kliment/catws/boardshape.dxf

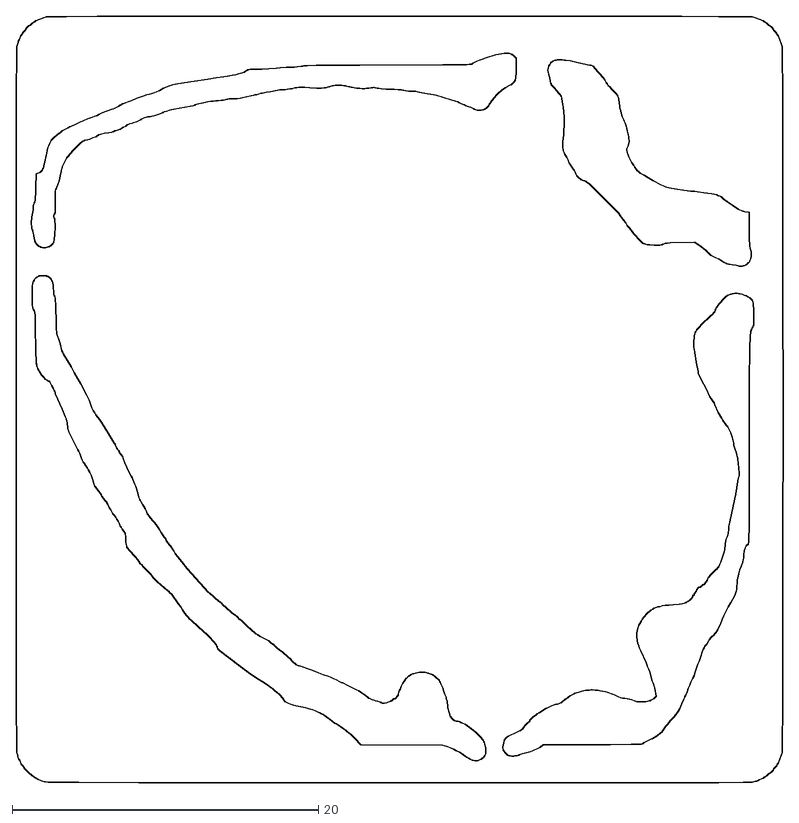
[picture p1: CAD file, 2019-01-30]
boardshape.dxf
50.1 x 50.1
