kliment/catws/boardshape.scad

translate([-51.5,-93.75])import("outline-npl.dxf");
