kliment/catws/catws-r2.kicad_pcb

## KiCad design catws-r2.kicad_pcb (2019-12-14)

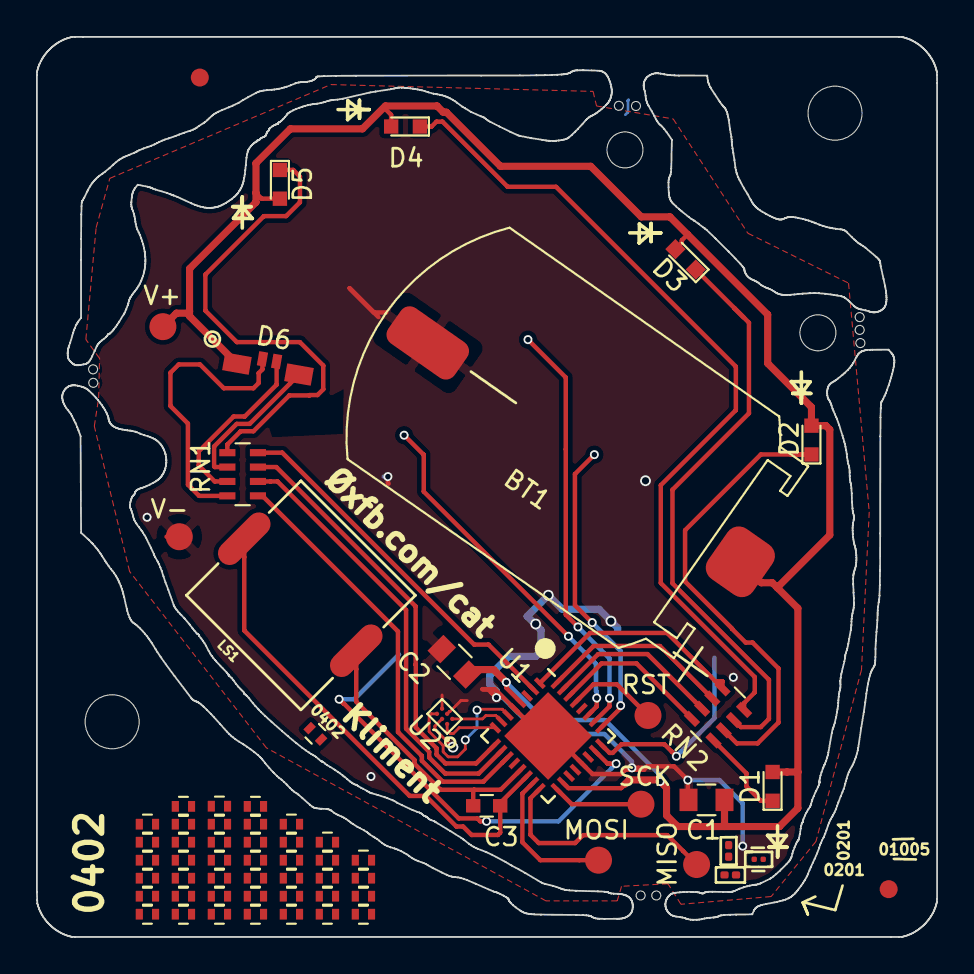
[picture p2: board catws-r2.kicad_pcb from above]

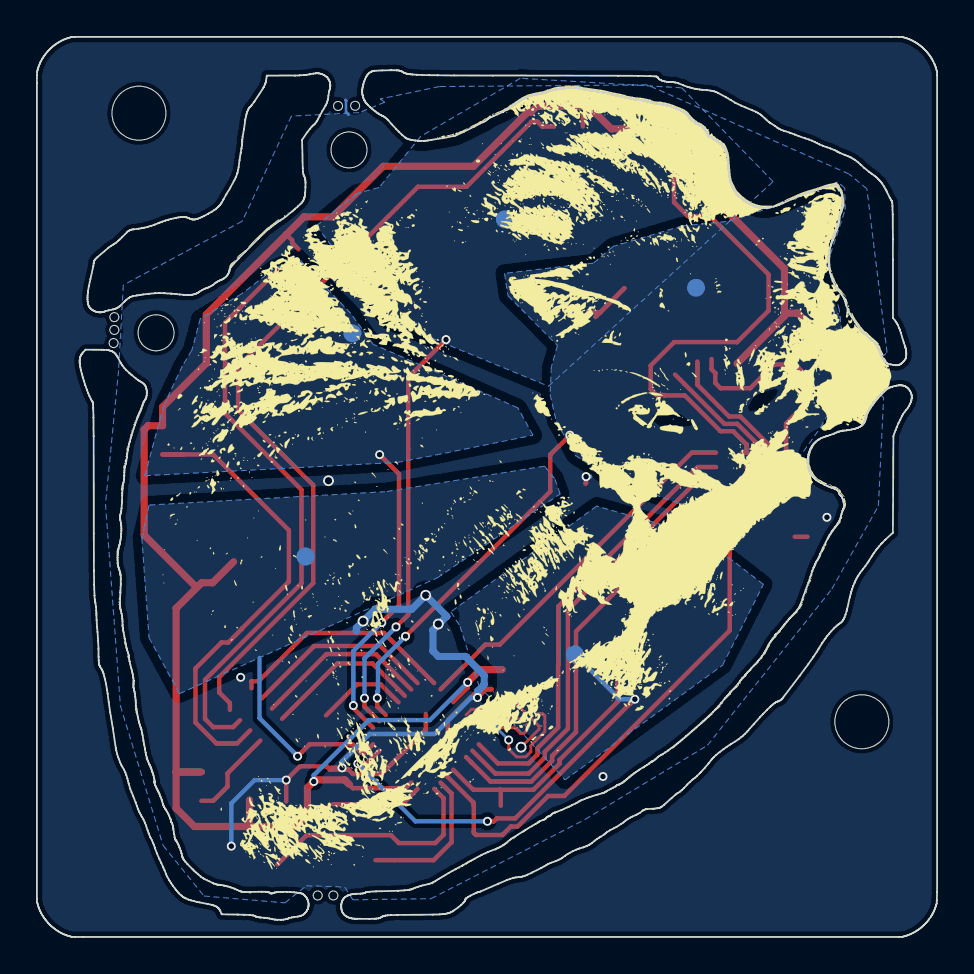
[picture p3: board catws-r2.kicad_pcb from below]

Board: 2 copper layers, 50.0 x 50.0 mm, 26 parts (5 on the bottom side), 32 nets.

Parts:
BT1: Battery_Cell; KLS5-CR2032-11
C1, C2: C; C_0805
C3: C; C_0603
D1, D2, D3, D4, D5: LED; LED_0603
D6: LED_ARGB; HQ12-2353RBGC
J1, J2, J3, J4, J5: TEST_1P; Measurement_Point_Round-SMD-Pad_Big
LS1: Speaker_Crystal; Murata-PKMCS
MISO: TEST_1P; Measurement_Point_Round-SMD-Pad_Small
MOSI: TEST_1P; Measurement_Point_Round-SMD-Pad_Small
RN1, RN2: R_Pack04; R_Array_Concave_4x0603
RST: TEST_1P; Measurement_Point_Round-SMD-Pad_Small
SCK: TEST_1P; Measurement_Point_Round-SMD-Pad_Small
U1: ATTINY88-MU; QFN-32-1EP_5x5mm_Pitch0.5mm
U2: BRCC064GWZ-3; WLCSP-6_1.4x1.0mm_P0.4mm
V+: TEST_1P; Measurement_Point_Round-SMD-Pad_Small
V-: TEST_1P; Measurement_Point_Round-SMD-Pad_Small

Connections:
/T0: J1.1, U1.23
/T1: J2.1, U1.24
/T2: J3.1, U1.25
/T3: J4.1, U1.26
/T4: J5.1, U1.27
GND: BT1.2, C1.2, C2.2, U1.5, U1.21, U2.A2, U2.B2, U2.B3, V-.1
unnamed: BT1.1, C1.1, C2.1, D1.2, D2.2, D3.2, D4.2, D5.2, D6.1, U1.4, U1.18, V+.1
unnamed: C3.1, LS1.1, U1.13
unnamed: C3.2, LS1.2, U1.14
unnamed: D1.1, RN2.1
unnamed: D2.1, RN2.2
unnamed: D3.1, RN2.3
unnamed: D4.1, RN2.4
unnamed: D5.1, RN1.5
unnamed: D6.2, RN1.6
unnamed: D6.3, RN1.7
unnamed: D6.4, RN1.8
unnamed: MISO.1, U1.16
unnamed: MOSI.1, U1.15
unnamed: RST.1, U1.29
unnamed: RN1.1, U1.11
unnamed: RN1.2, U1.10
unnamed: RN1.3, U1.9
unnamed: RN1.4, U1.2
unnamed: RN2.5, U1.1
unnamed: RN2.6, U1.32
unnamed: RN2.7, U1.31
unnamed: RN2.8, U1.30
unnamed: SCK.1, U1.17
unnamed: U1.6, U2.A3
unnamed: U1.7, U2.B1
unnamed: U1.8, U2.A1
