kliment/catws/manual.pdf

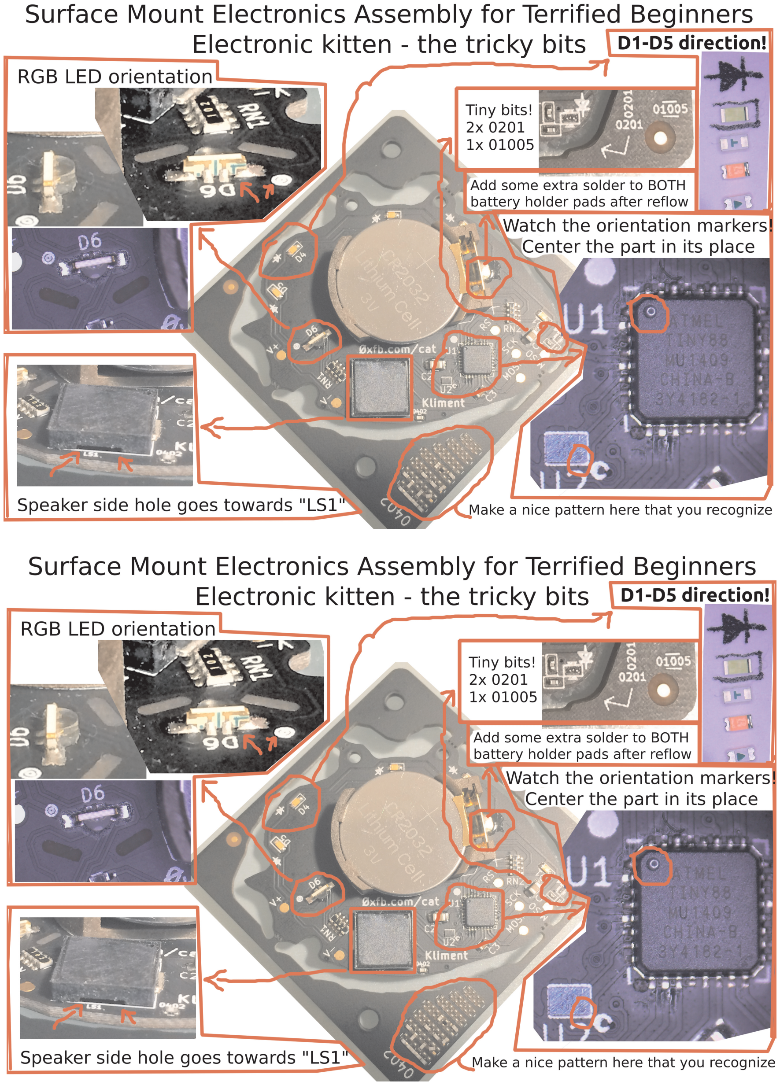
[picture p4: page 1]
