kliment/catws/(commit log)

2019-02-10 Implement low power sleep mode Add horrible hiss and horrible loud purr Add broken time-based measurement mode
    [main.c]
2019-02-10 Fix overstim some more
    [main.c]
2019-02-10 Plateau happiness before overstim
2019-02-19 Revert "Reduce purr duration after petting has stopped."
    This reverts commit 9a0ce220ef02b9019fc9a824d8e155b2acef64fa.
    [main.c]
2019-04-13 second revision layout and schema differential drive for piezo add cap in parallel with piezo add tricky footprints (0201, 01005, µBGA2x3)
    [catws-r2.kicad_pcb, catws-r2.sch]
2019-12-14 Add missing library cache files and minor changes to firmware sensitivity thresholds
    [catws-r2.kicad_pcb]
2022-08-27 Add manual PDF and latest revision of PCB (for 2022 workshops)
    [catws-r4.kicad_pcb]
